philippedc/ESP32-TTGO-T-Display-webradio-LW-MW-AM-broadcasted/20251026_174141.jpg

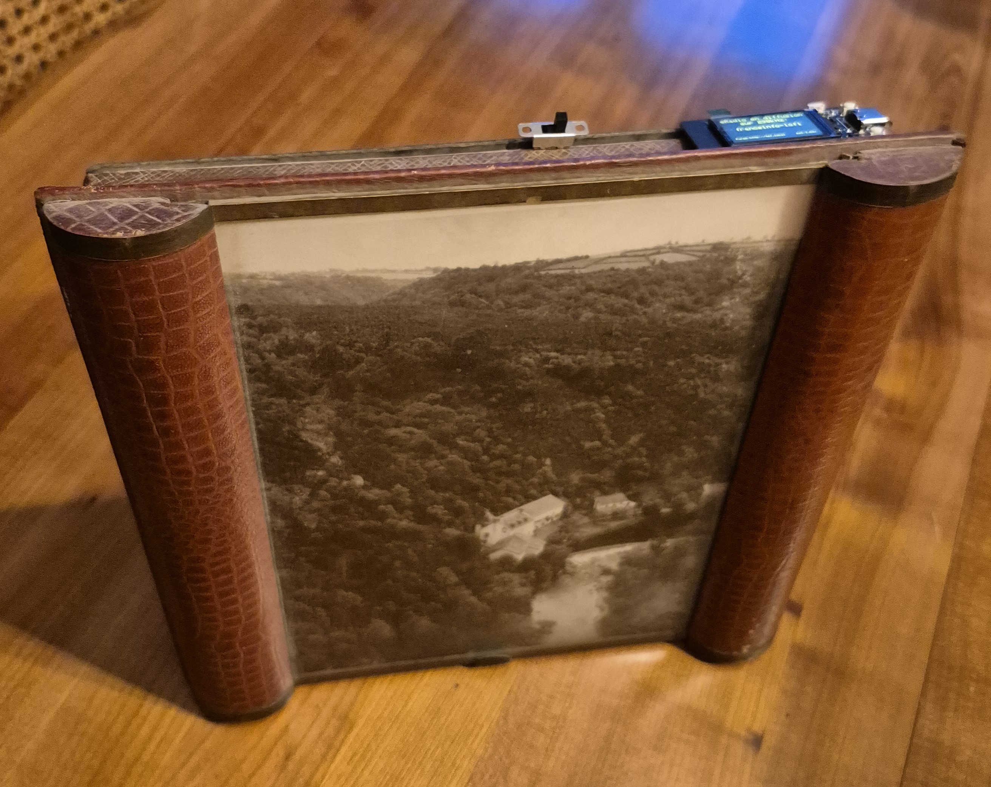
20251026_174141.jpg
