philippedc/ESP32-TTGO-T-Display-webradio-LW-MW-AM-broadcasted/AM transmitter diagram.png

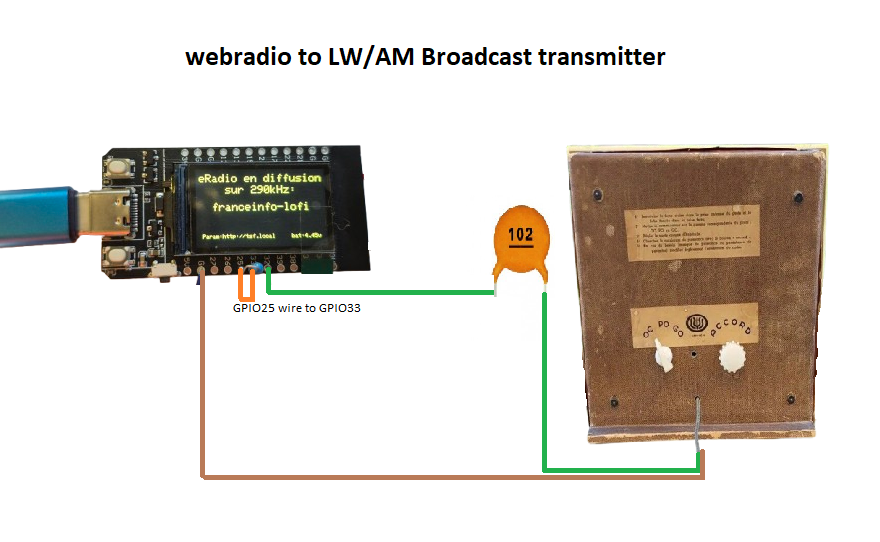
AM transmitter diagram.png
