philippedc/ESP32-TTGO-T-Display-webradio-LW-MW-AM-broadcasted/README.md

Here is a device to make old radios alive again!

There are 2 versions:

- the V0 or V1 it is an all-in-one transmitter with an ESP32, for a very low power transmitter,

- the V2 it is a project with a separate modulator and amplifier, much more powerfull. For the description of the V2 version see the according pdf file.

Below it is the first version, the simpliest version all-in-one. 

AM transmitter diagram

I wanted a very simple device, low energy, easy to use, that will AM transmit so that I can listen back my old radios.

Here the signal to transmit comes from a builtin web-radio, instead of a Bluetooth receiver.

Web radio stations are received by wifi, then the "analog" audio signal is PWMed at a chosen radio frequency.

The analog audio is 8 bits defined; but it is enough for a last century radio player!

Due to the PWM characteristics of the ESP32, for a 8 bits definition, the PWM frequency must be under 300kHz.

So the transmitter looks like more for a LW reception than  MW. Nevertheless, the output is a square signal, so the harmonic 2 and 3  can be listened on MW.
The power output is so ridiculous with a power supply of 3.3V that you will not disturb your neighbors.

The antenna can be a simple wire, or an old antenna frame  like the one I use. The distance between the antenna frame and the radio  is less than 1 meter.

The TTGO T-Display offers the connection for a Lithium battery, so the transmitter is a portable device.
Take care of the IDE, Expressif, and Audio library version.
