philippedc/ESP32-TTGO-T-Display-webradio-LW-MW-AM-broadcasted/20251026_174134.jpg

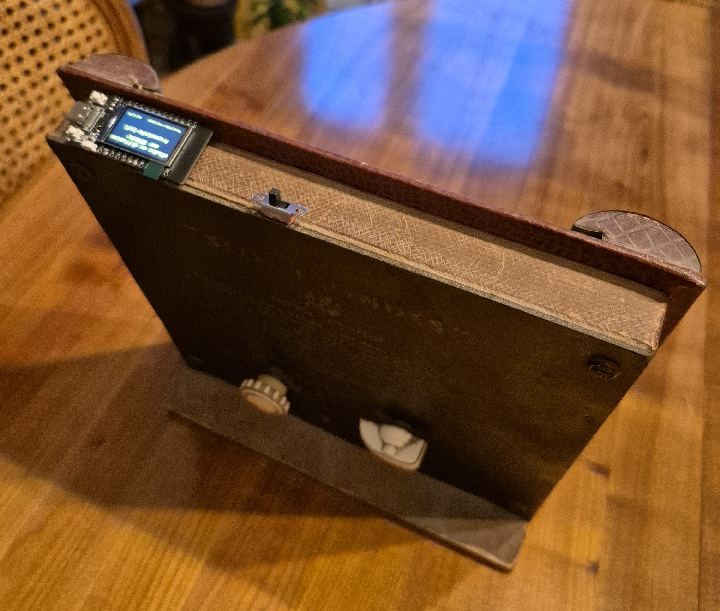
20251026_174134.jpg
