philippedc/ESP32-TTGO-T-Display-webradio-LW-MW-AM-broadcasted/20251026_174154.jpg

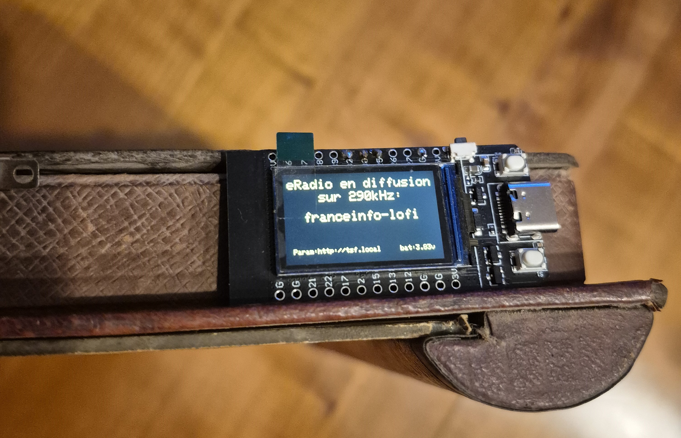
20251026_174154.jpg
