philippedc/ESP32-TTGO-T-Display-webradio-LW-MW-AM-broadcasted/Schematic_AM-transmitter-v2_2026-01-31.pdf

## GND

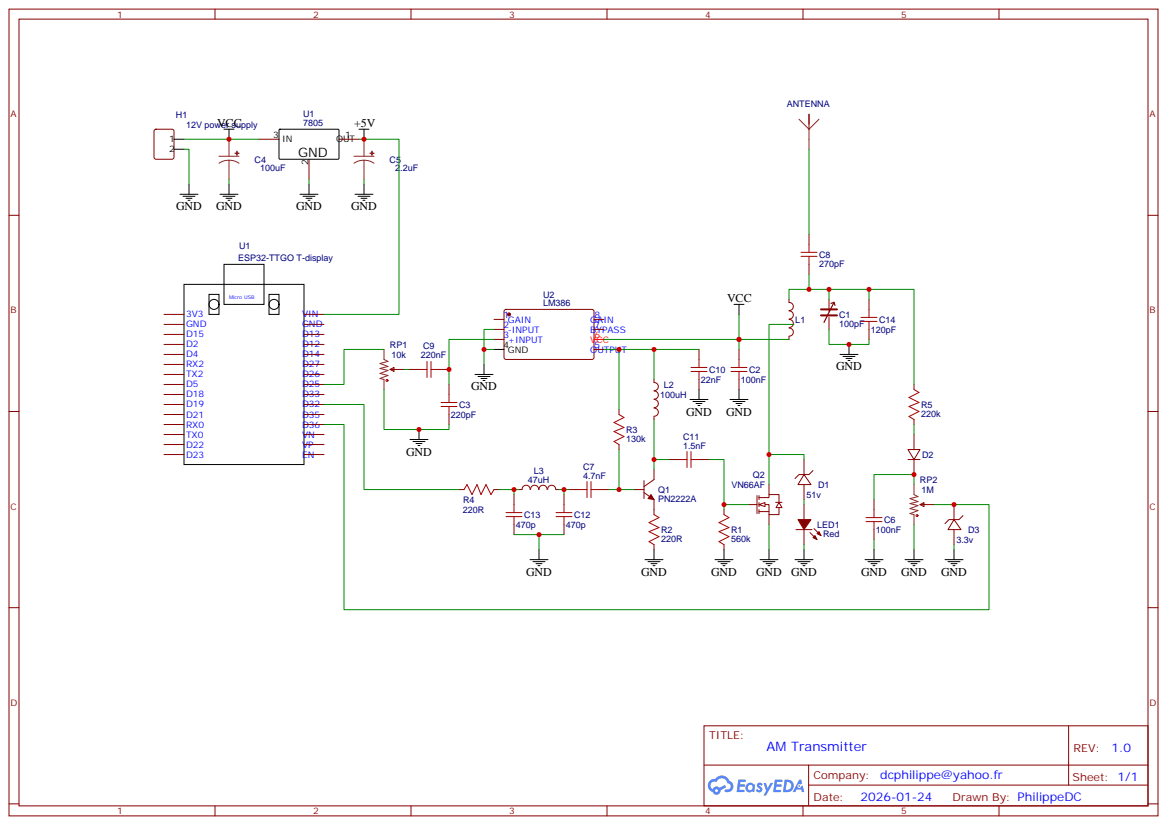
[picture p11: page 1]

Company: dcphilippe@yahoo.fr
